defining/SmartThermostat/Présentations/Mi-parcours présentation BA2.pdf

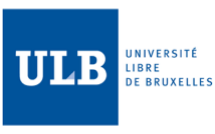
[picture p61: figure]

# « Thermostat intelligent »

## Groupe 11

Membres :
AMZUR Soufiane
DAUBRY Wilson
SERCU Stéphane
VERSTRAETEN Denis

Superviseur :
EPPE Stefan

1. Introduction
2. Conception
3. Thermostats auxiliaires
4. Thermostat central
5. Perspectives d’évolution
6. Conclusion

# Tables des matières

# Introduction

- Demande en objets intelligents croissante
- Création du thermostat connecté
- Utilisation simple et intuitive pour l’utilisateur

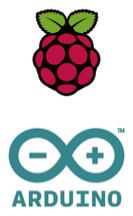
[picture p62: figure]

- Périphériques
- Central : Raspberry Pi Model 2b
- Auxiliaires : Arduino Nano V2

# Conception

- Diagramme complet
- Vue globale et structurée
- Partage efficace des différentes parties
- Développé dans la suite de la présentation

# Thermostats auxiliaires

Hardware

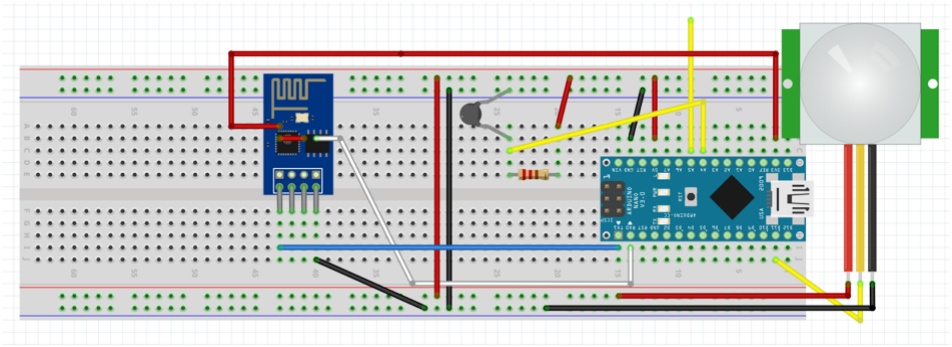
[picture p63: figure]

- Arduino Nano V2
- Thermistance
- PIR
- Module Wi-Fi
- Vanne thermostatique 4

# Thermostats auxiliaires

Software

- PIR : HIGH ou LOW
- Vanne thermostatique : valeur analogique convertie en %
- Thermistance : valeur analogique convertie en tension, obtention de la température grâce à la loi de Steinhart-Hart

Lecture des capteurs :

# Thermostats auxiliaires

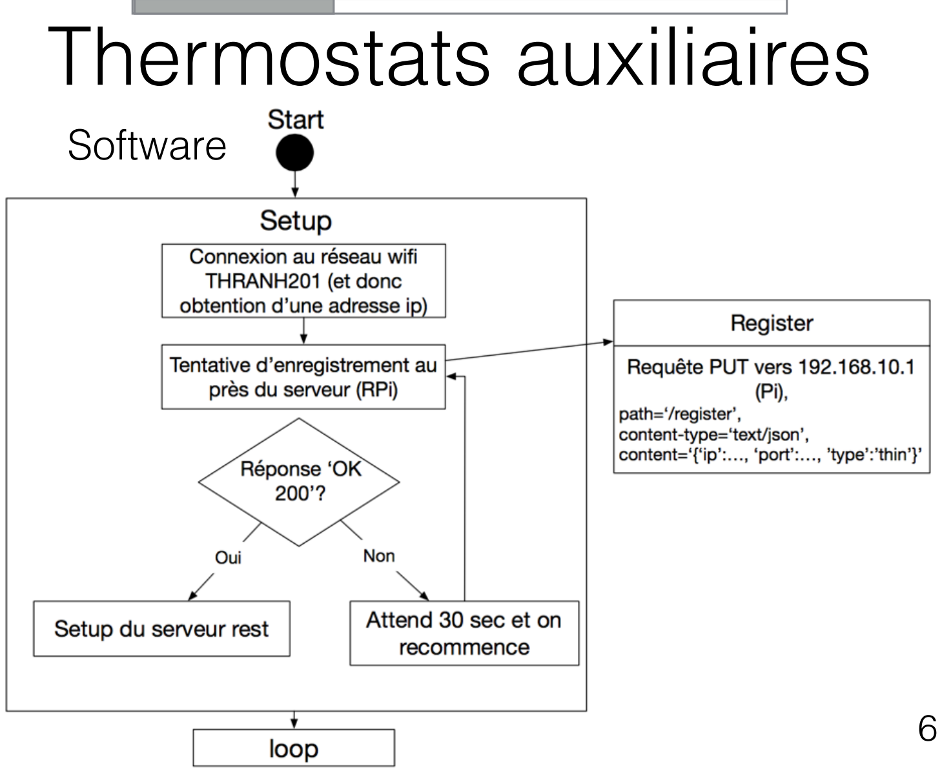
[picture p64: page 7]

Software

# Thermostats auxiliaires

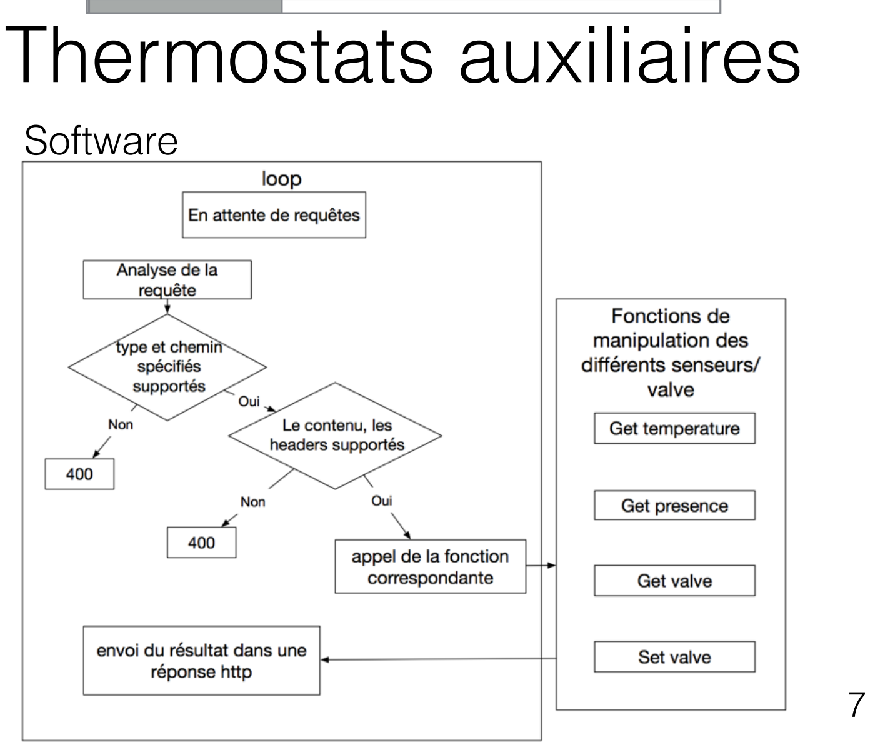
[picture p65: page 8]

Software

# Thermostat central

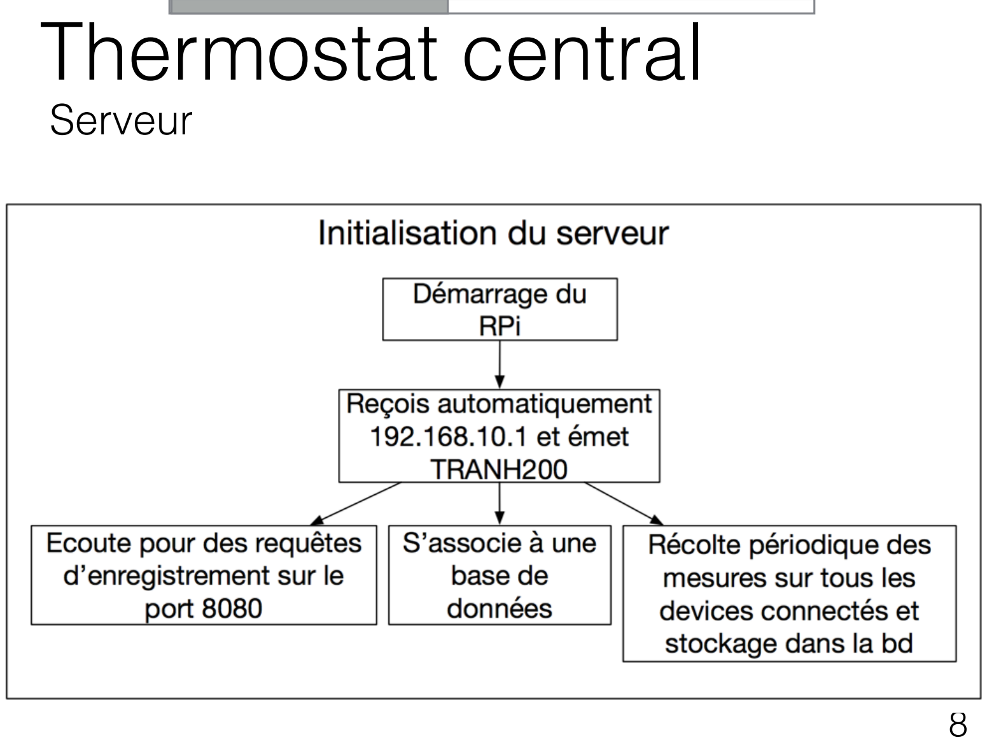
[picture p66: page 9]

Serveur

# Thermostat central

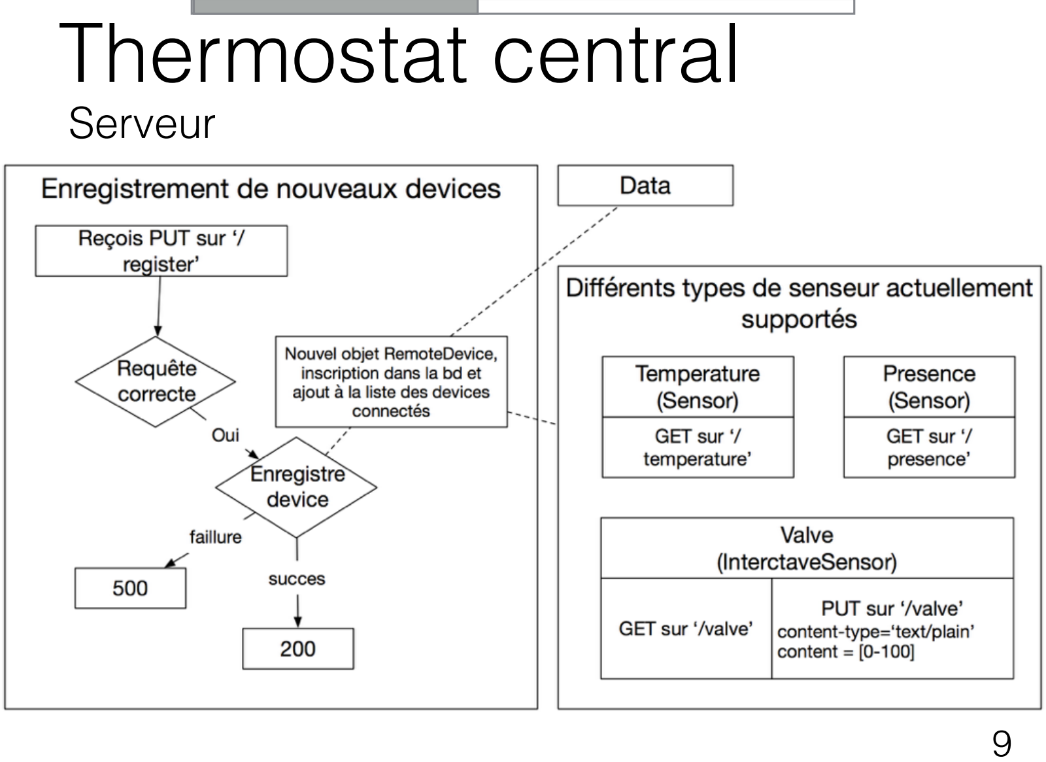
[picture p67: page 10]

Serveur

# Thermostat central

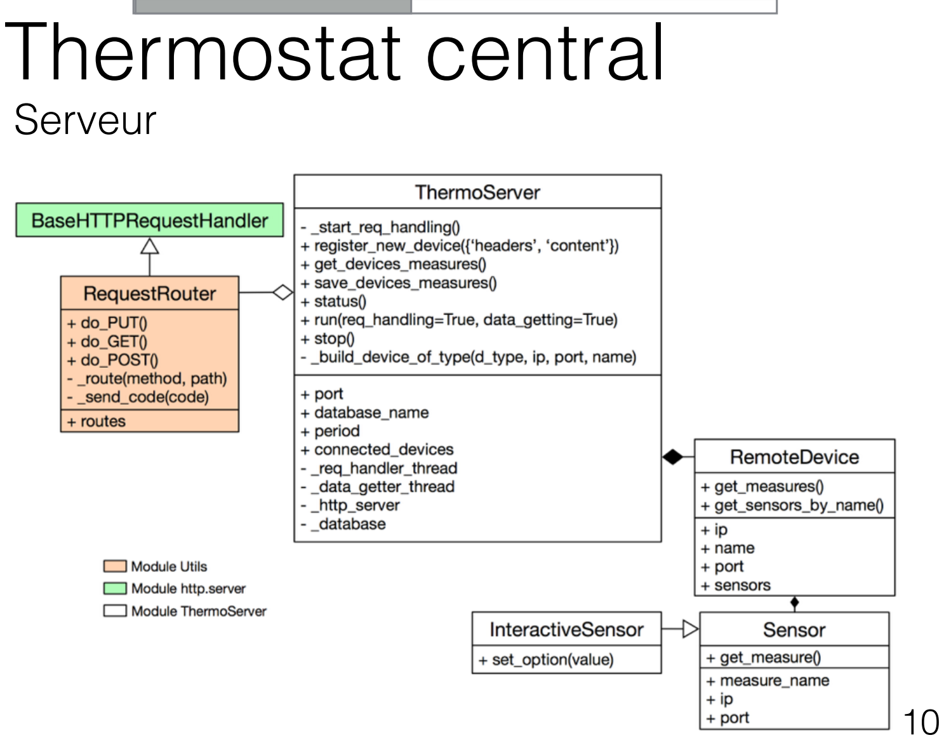
[picture p68: page 11]

Serveur

# Thermostat central

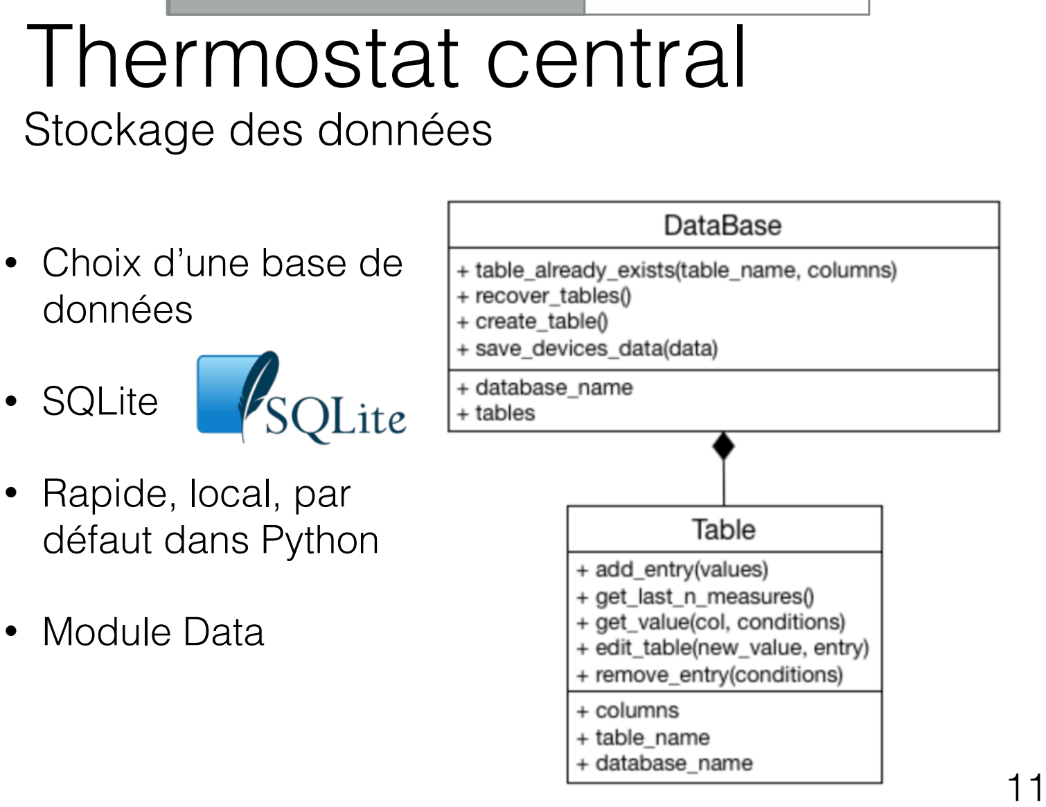
[picture p69: page 12]

- Choix d’une base de
données
- SQLite
- Rapide, local, par
défaut dans Python
- Module Data

Stockage des données

# Thermostat central

Stockage des données

- Une nouvelle table par connexion
- Pas correct

Implémentation actuelle

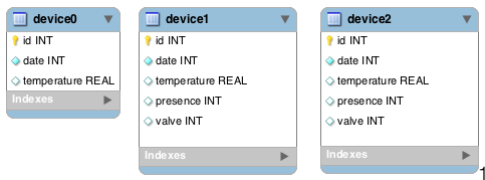
[picture p70: figure]

# Thermostat central

Stockage des données

- Une table principale
- Une table de Remote Devices

Implémentation à venir

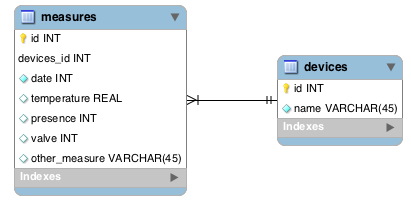
[picture p71: figure]

# Perspectives d’evolution

- Validation entière du système
- Analyse critique du sytème
- Modélisation dynamique du chauffage
- Modélisation de l’algorithme anticipatif
- Implémentation algorithme « smart »
- Tests et validation

# Conclusion

- Câblage Remote Devices
- Implémentation Arduino
- Implémentation serveur
- Implémentation base de données
- Communication entre Remote Devices et serveur

Bibliographie : cf.rapport intermédiaire

Merci pour votre attention.

# Relation de Steinhart-Hart

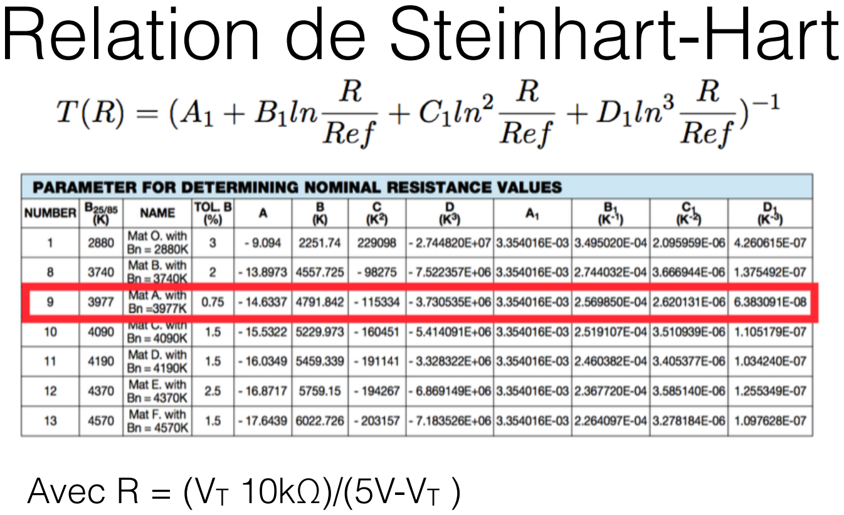
[picture p72: page 18]

Avec R = (VT 10kΩ)/(5V-VT )
