defining/SmartThermostat/Présentations/Présentation finale.pdf

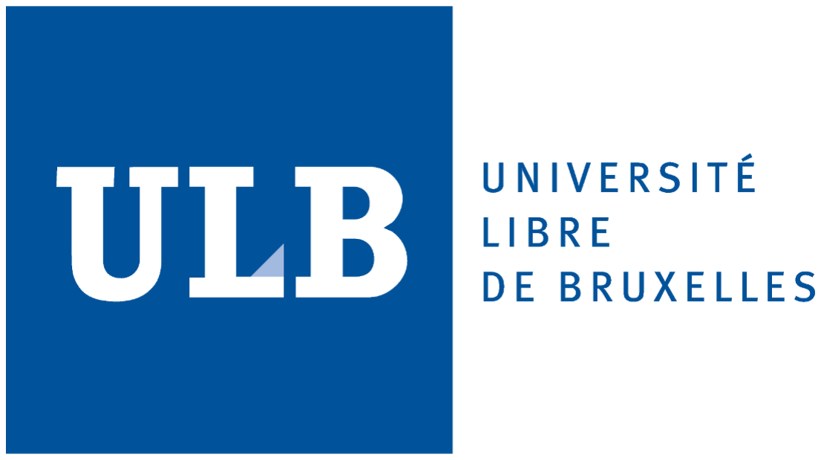
[picture p73: figure]

# « Thermostat intelligent »

## Groupe 11

Membres :
AMZUR Soufiane
DAUBRY Wilson
SERCU Stéphane
VERSTRAETEN Denis

Superviseur :
EPPE Stefan

Lecteur :
VERMEIR Aurélien

1. Introduction
2. Conception
3. Thermostats auxiliaires
4. Thermostat central
5. Intelligence
6. Validation
7. Conclusion

# Table des matières

# Introduction

- Demande en objets intelligents croissante
- Création du thermostat connecté
- Utilisation simple et intuitive pour l’utilisateur

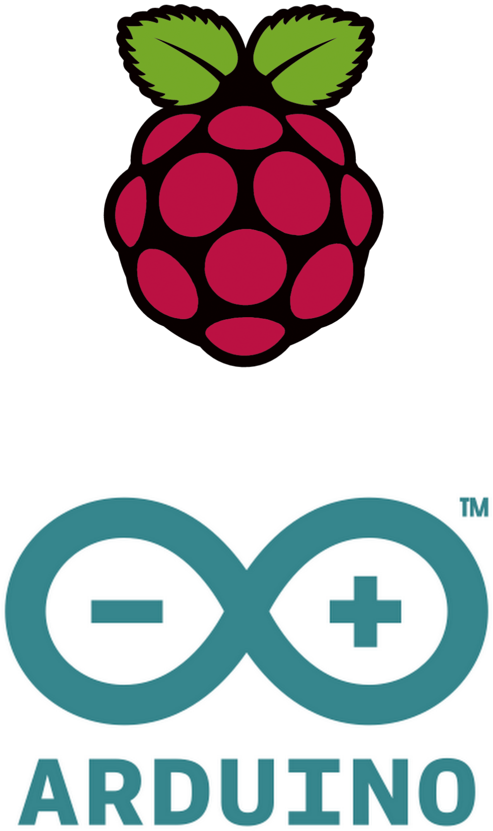
[picture p74: figure]

- Périphériques
- Central : Raspberry Pi Model 2b
- Auxiliaires : Arduino Nano V2

# Conception

- Diagramme complet
- Vue globale et structurée
- Partage efficace des différentes parties
- Développé dans la suite de la présentation

# Thermostats auxiliaires

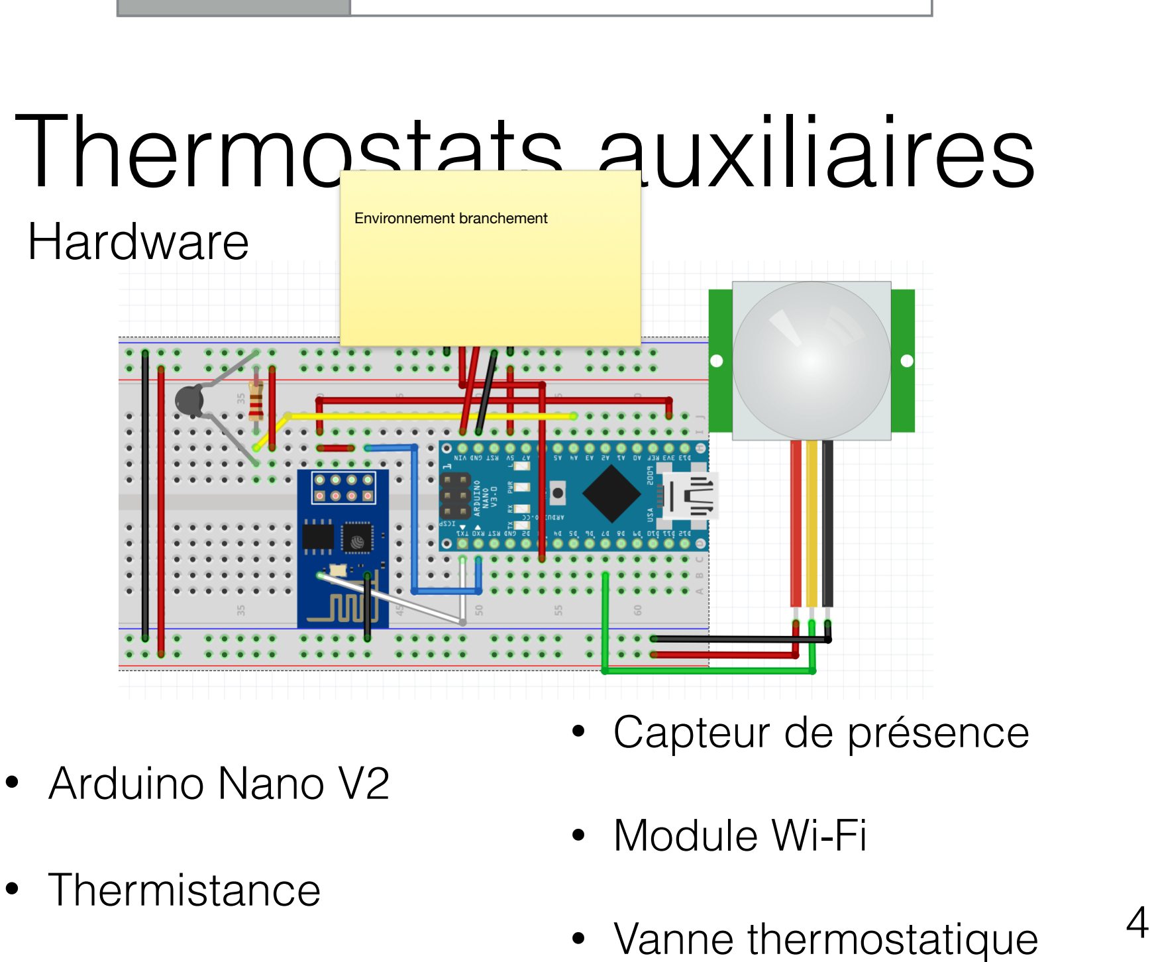
[picture p75: page 5]

Hardware

- Arduino Nano V2
- Thermistance
- Capteur de présence
- Module Wi-Fi
- Vanne thermostatique 4

Environnement branchement

# Thermostats auxiliaires

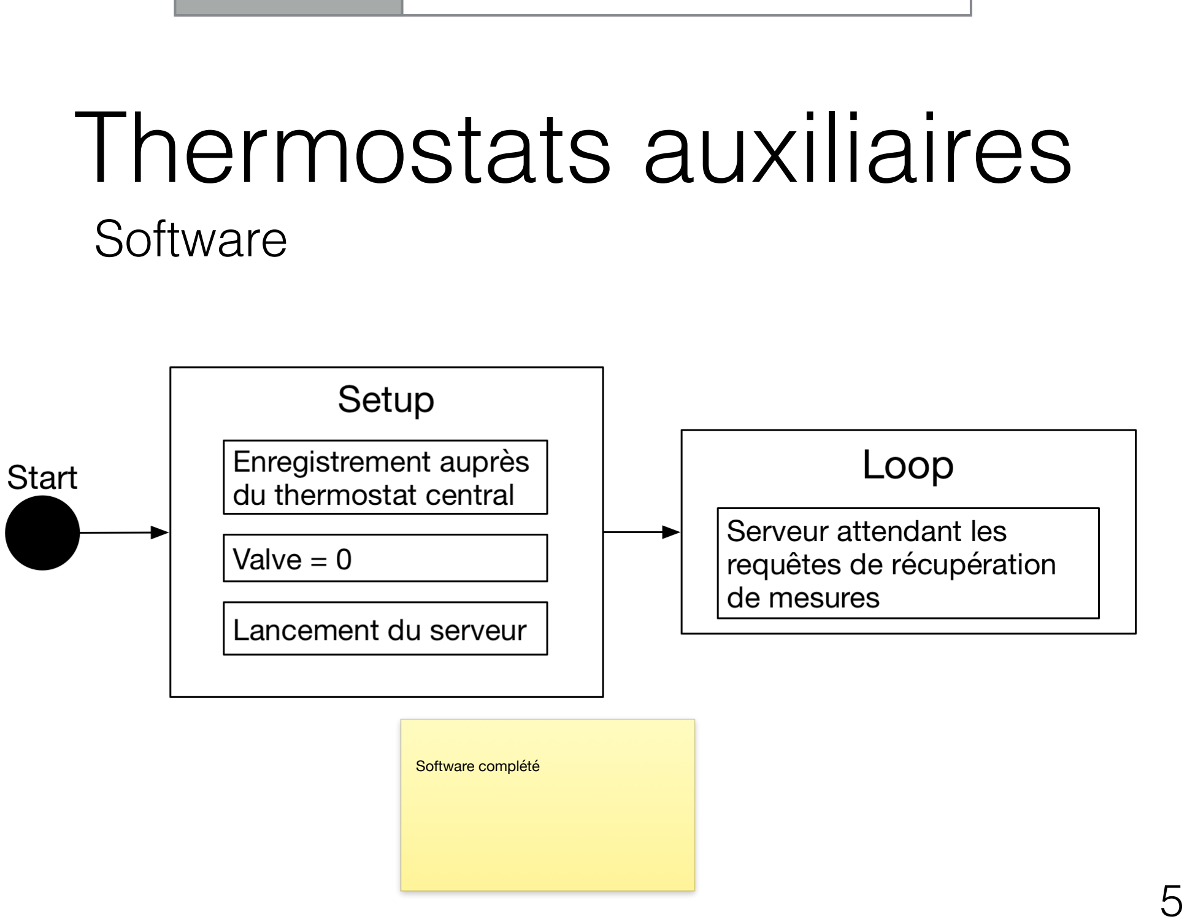
[picture p76: page 6]

Software

Software complété

# Thermostat central

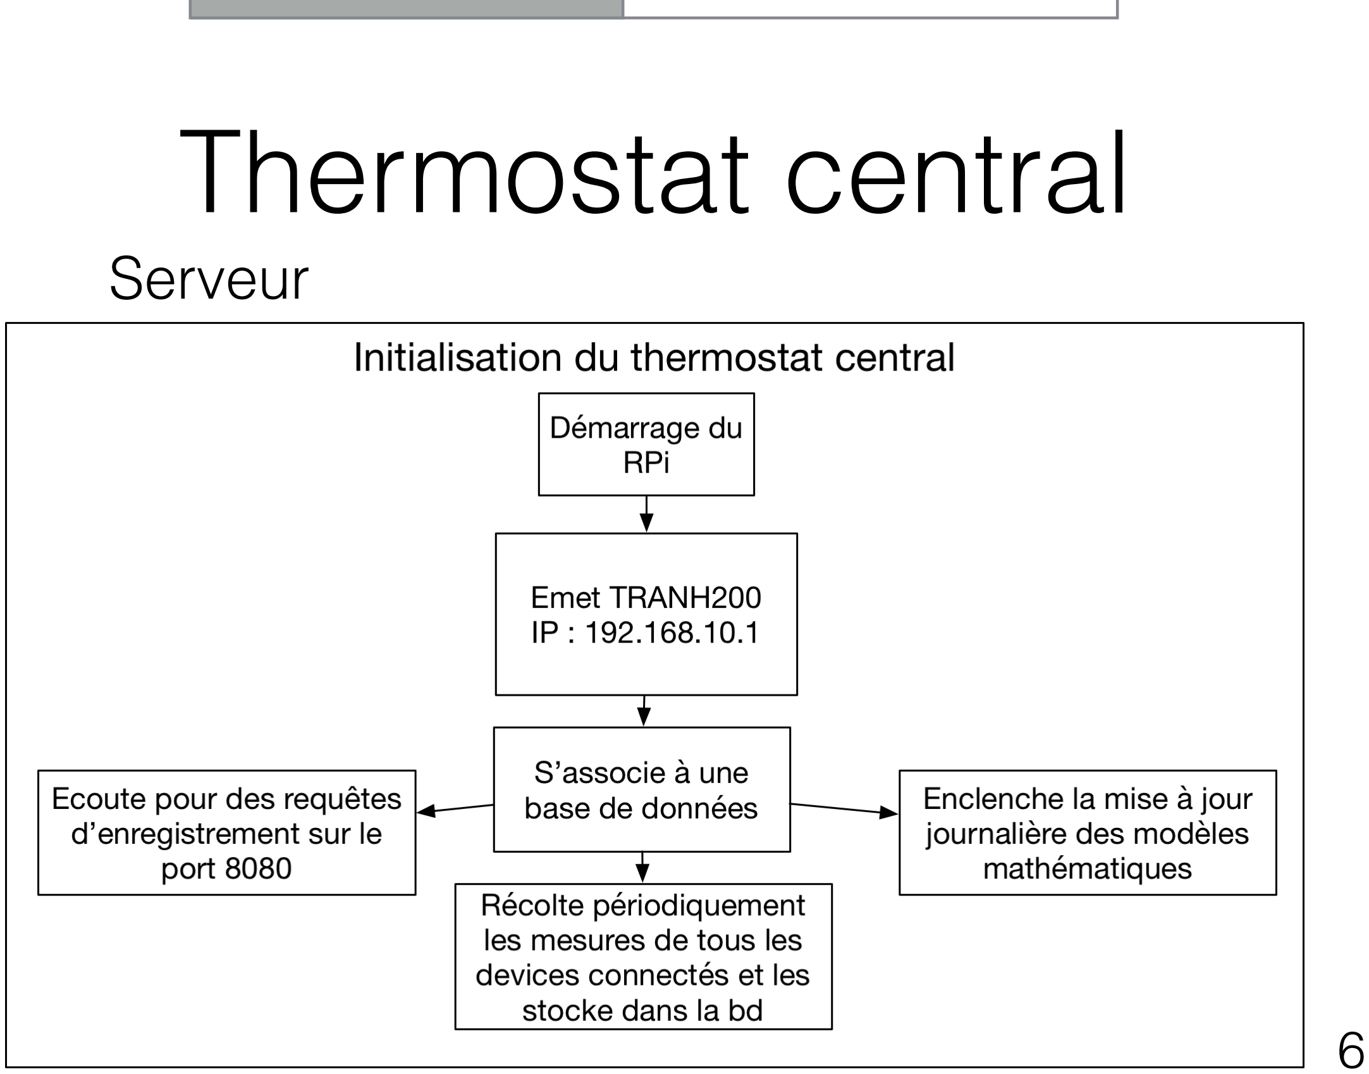
[picture p77: page 7]

Serveur

# Thermostat central

Serveur

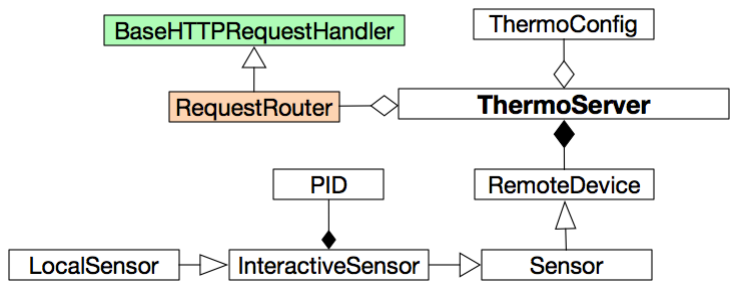
[picture p78: figure]

# Thermostat central

- Choix d’une base de
données

•

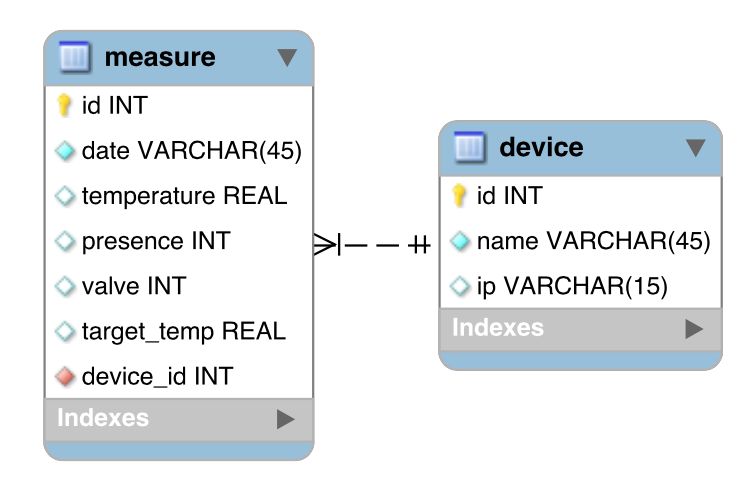
[picture p79: figure]
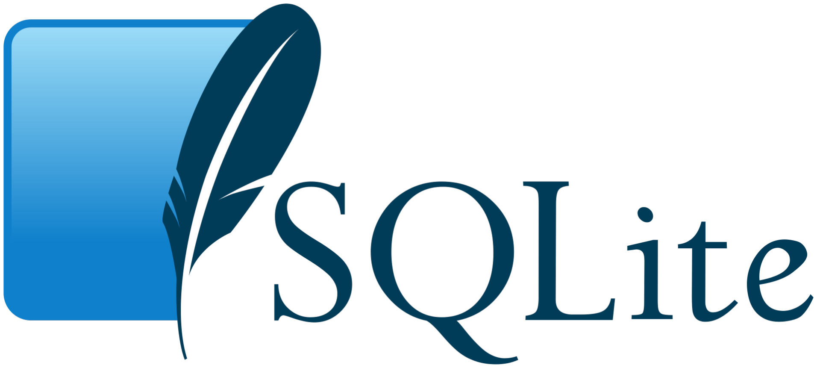
[picture p80: figure]

- Local, par défaut dans
Python
- Module Data

Stockage des données

# Thermostat central

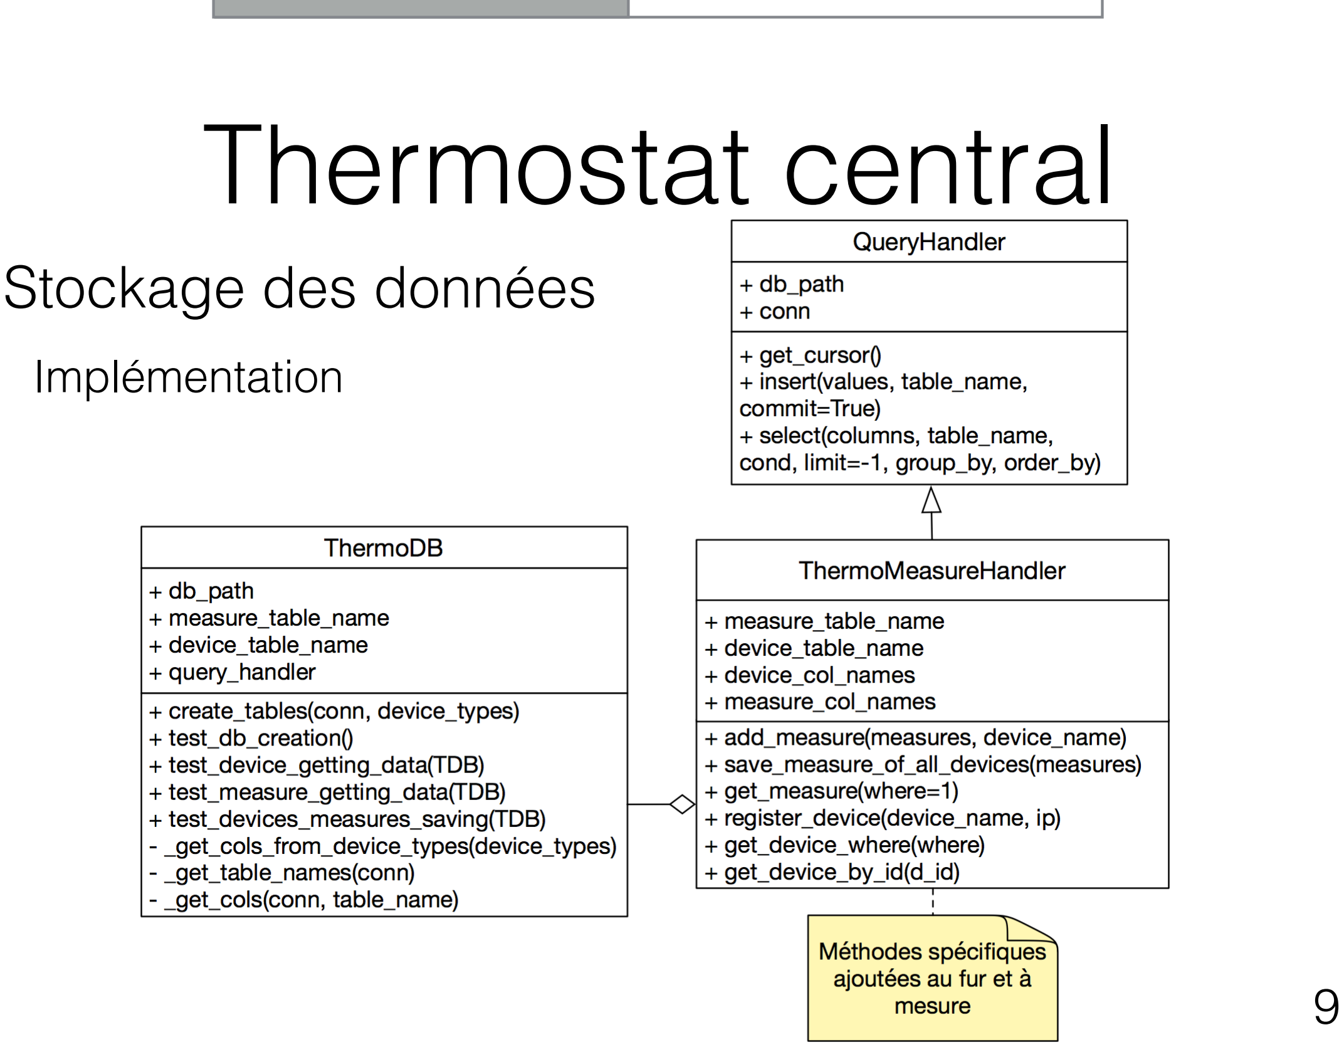
[picture p81: page 10]

Stockage des données

Implémentation

# Thermostat central

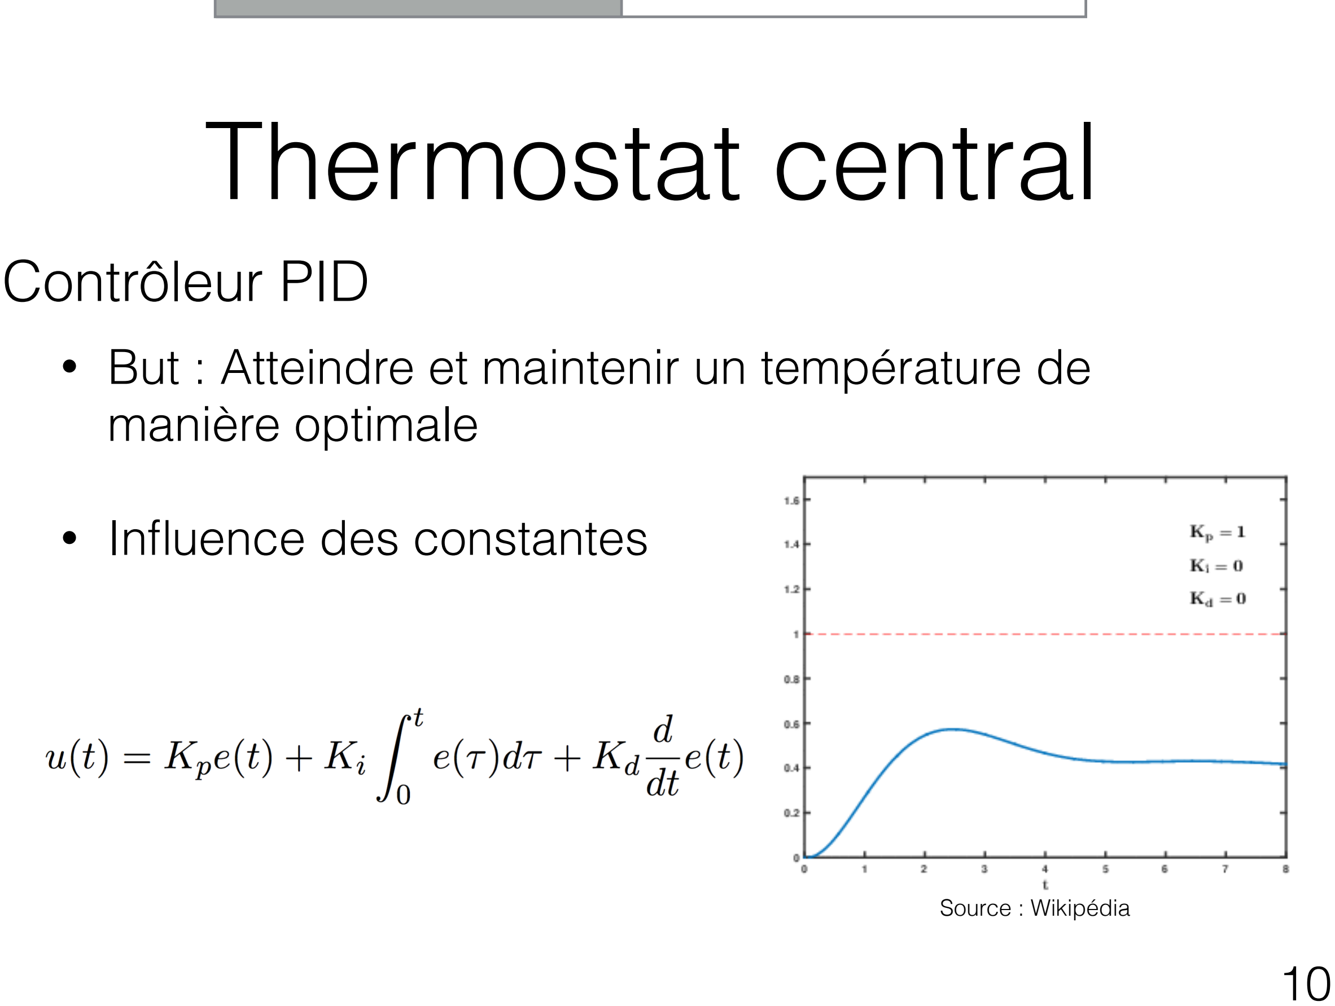
[picture p82: page 11]

Contrôleur PID

- But : Atteindre et maintenir un température de manière optimale
- Influence des constantes

Source : Wikipédia

# Intelligence

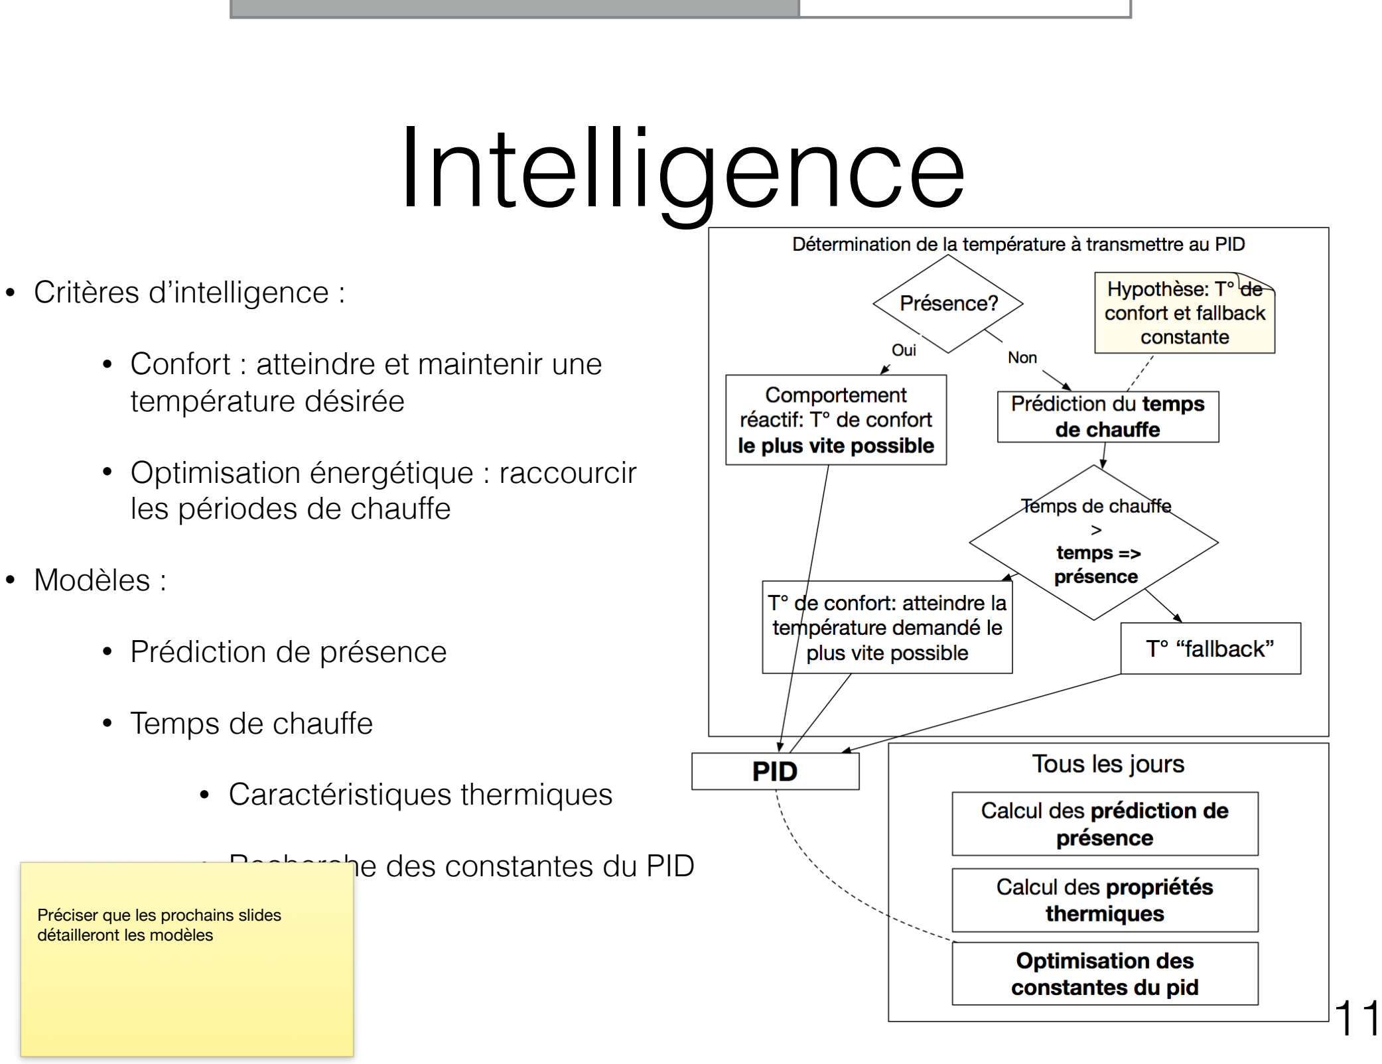
[picture p83: page 12]

- Critères d’intelligence :
- Confort : atteindre et maintenir une température désirée
- Optimisation énergétique : raccourcir les périodes de chauffe
- Modèles :
- Prédiction de présence
- Temps de chauffe
- Caractéristiques thermiques
- Recherche des constantes du PID

Préciser que les prochains slides détailleront les modèles

# Intelligence

Prédiction de présence

- Fonction de probabilité
- Interpolation polynomiale

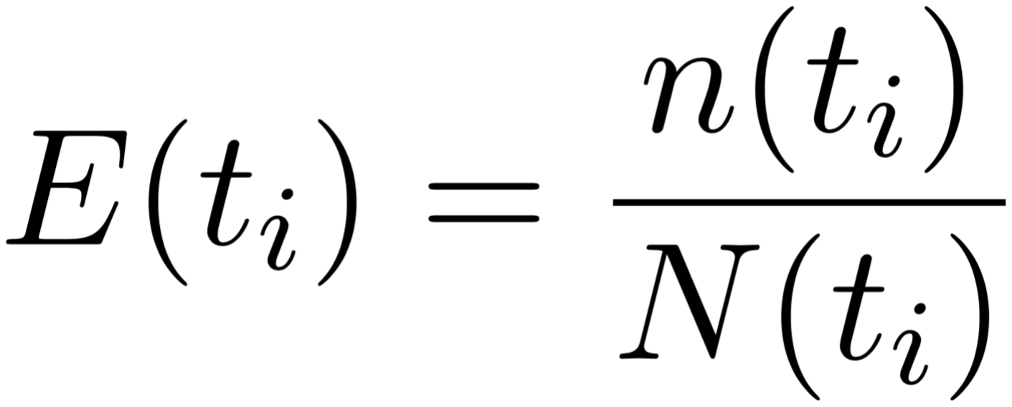
[picture p84: figure]
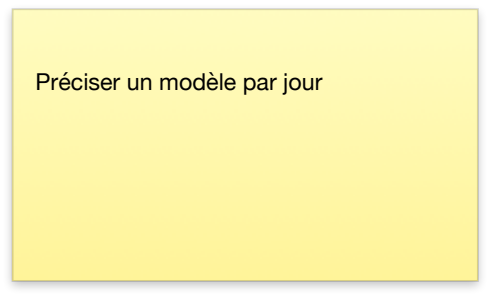
[picture p85: figure]
Préciser un modèle par jour
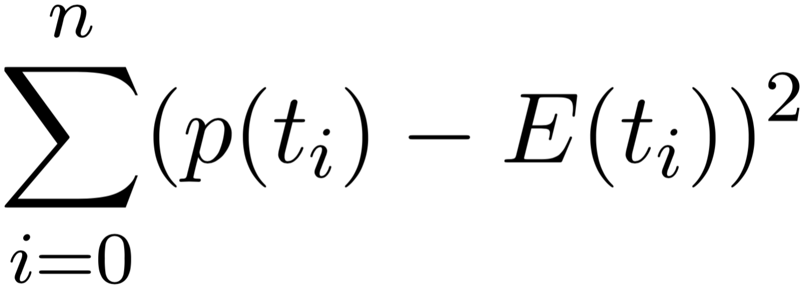
[picture p86: figure]

# Intelligence

Caractéristiques thermiques

- Evolution de la température
- Bilan énergétique

- Minimisation de la différence entre la température actuelle et la température désirée

# Intelligence

Recherche des constantes du PID

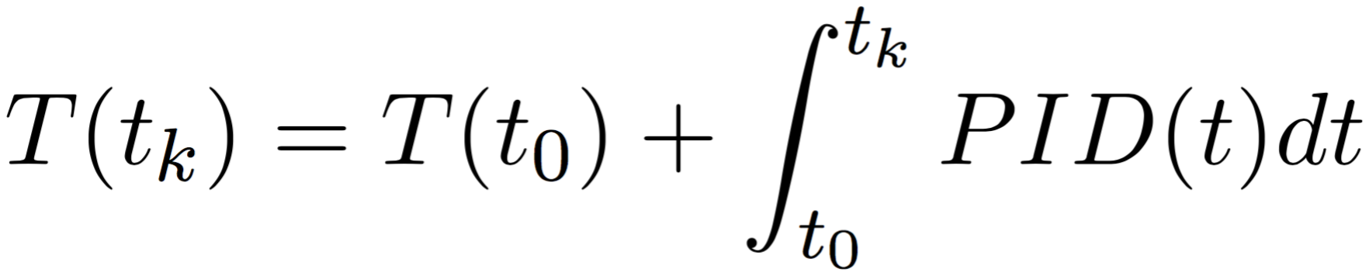
[picture p87: figure]
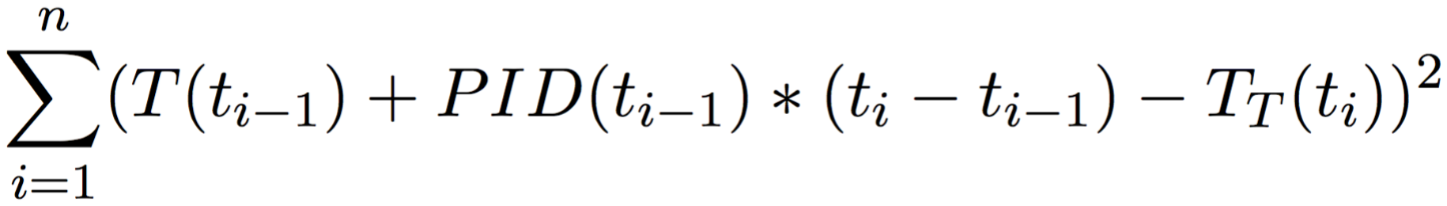
[picture p88: figure]

# Validation

Tests d’implémentation

- Tests du « thin thermostat »
- Tests unitaires des modules du serveur
- Tests généraux du serveur

# Validation

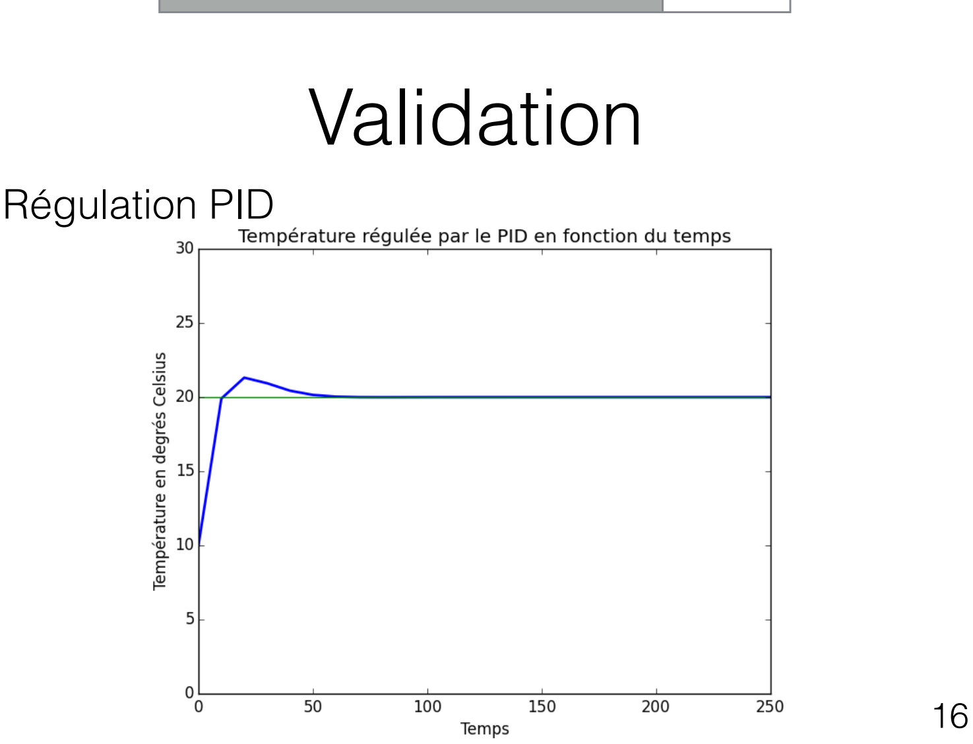
[picture p89: page 17]

Régulation PID

# Validation

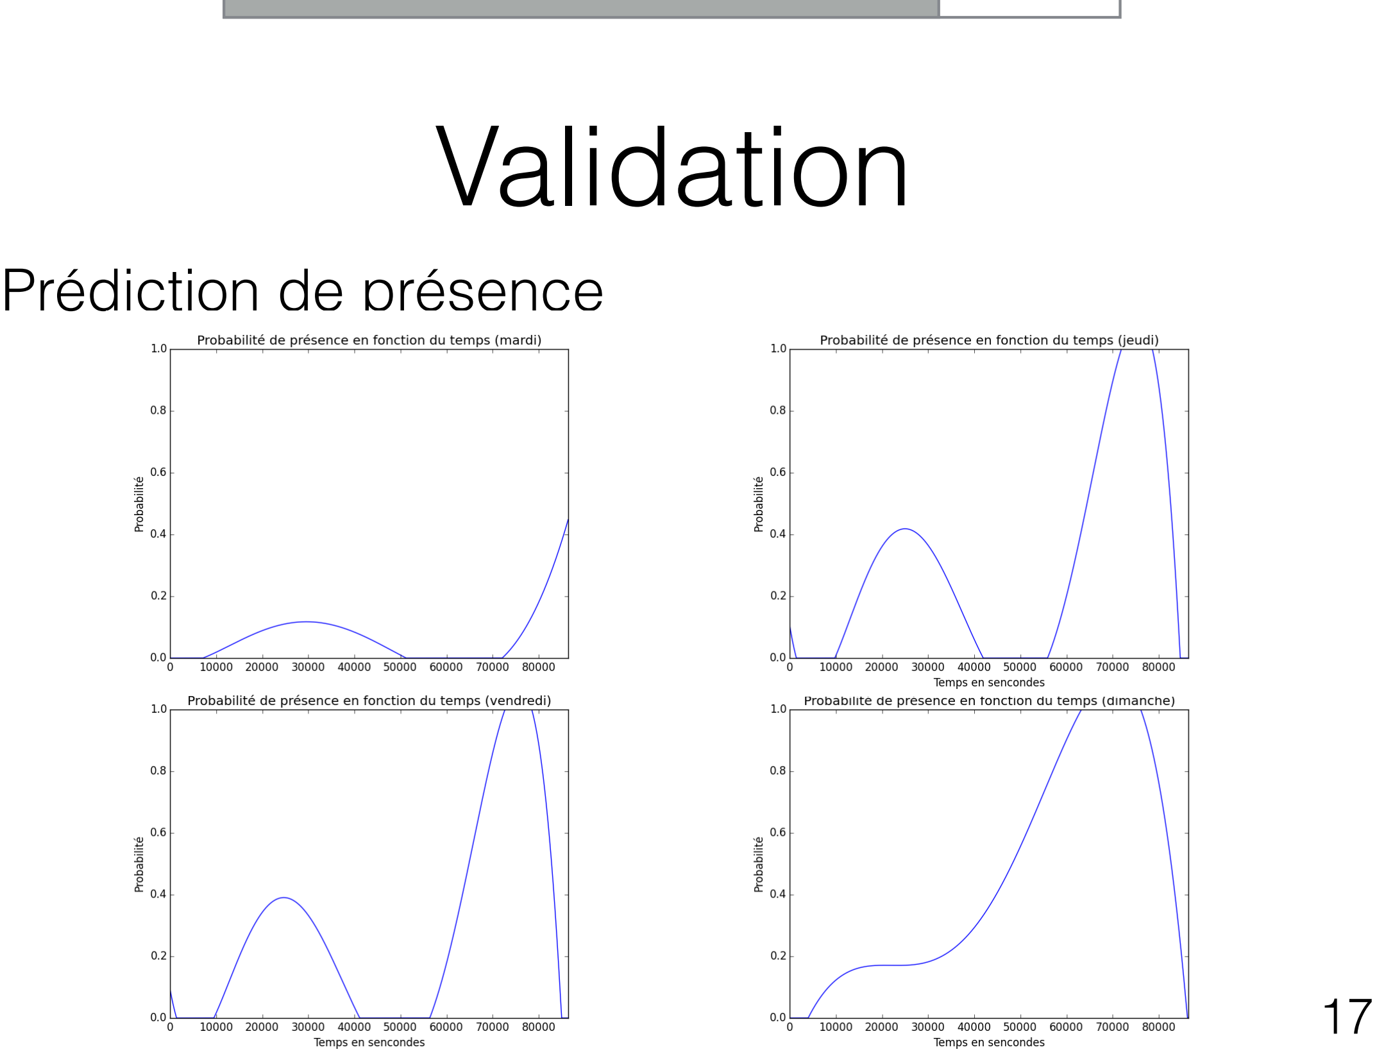
[picture p90: page 18]

Prédiction de présence

# Conclusion

- Perspectives d’évolution
- Corriger certains et affiner les modèles théoriques
- Identification des Remote Devices
- Ajouter d’autres types de senseurs
- Affiner la notion de confort
- Interface graphique, accès aux informations
- Optimiser
- Réflexion
- Pas de perte de temps sur le débogage

Bibliographie : cf.rapport intermédiaire

Merci pour votre attention

# Annexe

A1

- Fonctionnement de groupe
- Une réunion par semaine
- OverLeaf
- Dropbox
- Skype
- Facebook

# Annexe

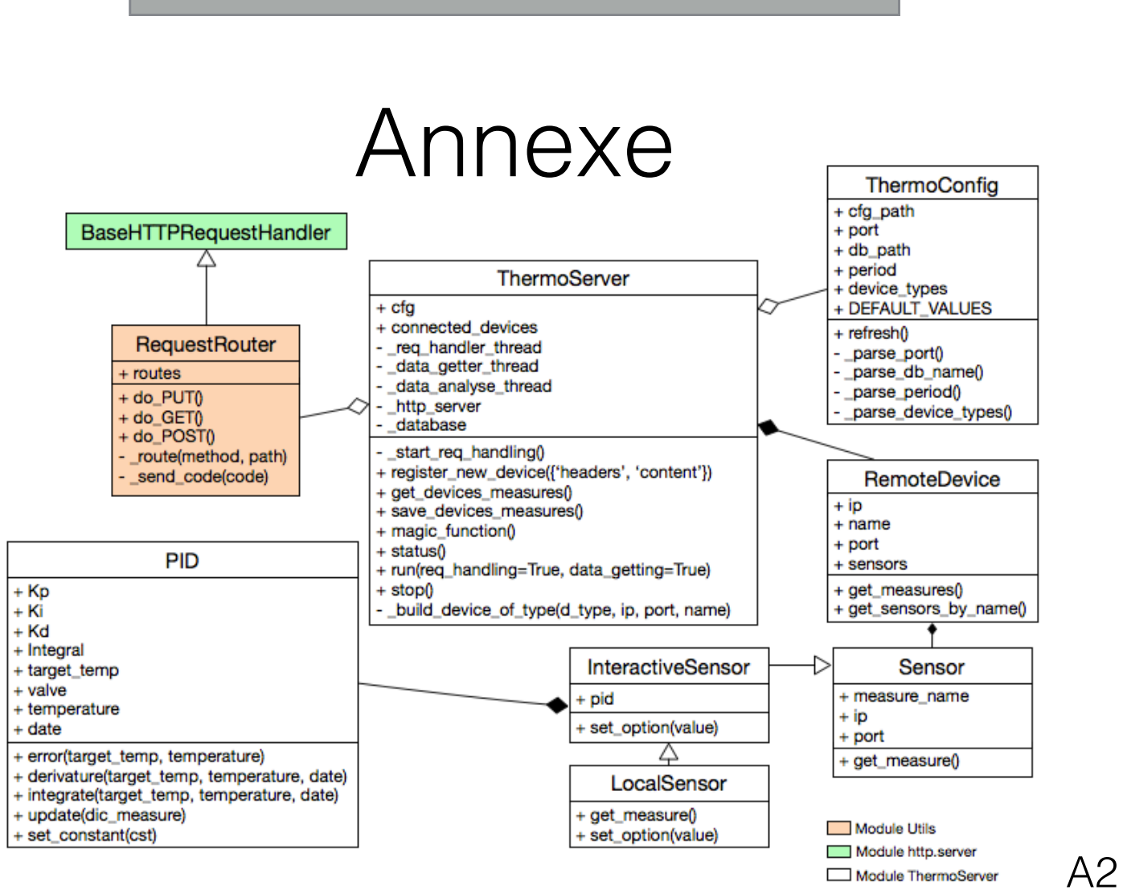
[picture p91: page 22]

A2
