defining/SmartThermostat/Rapports/Rapport final/thermostat-connecte/pdf/diagrams_complet.pdf

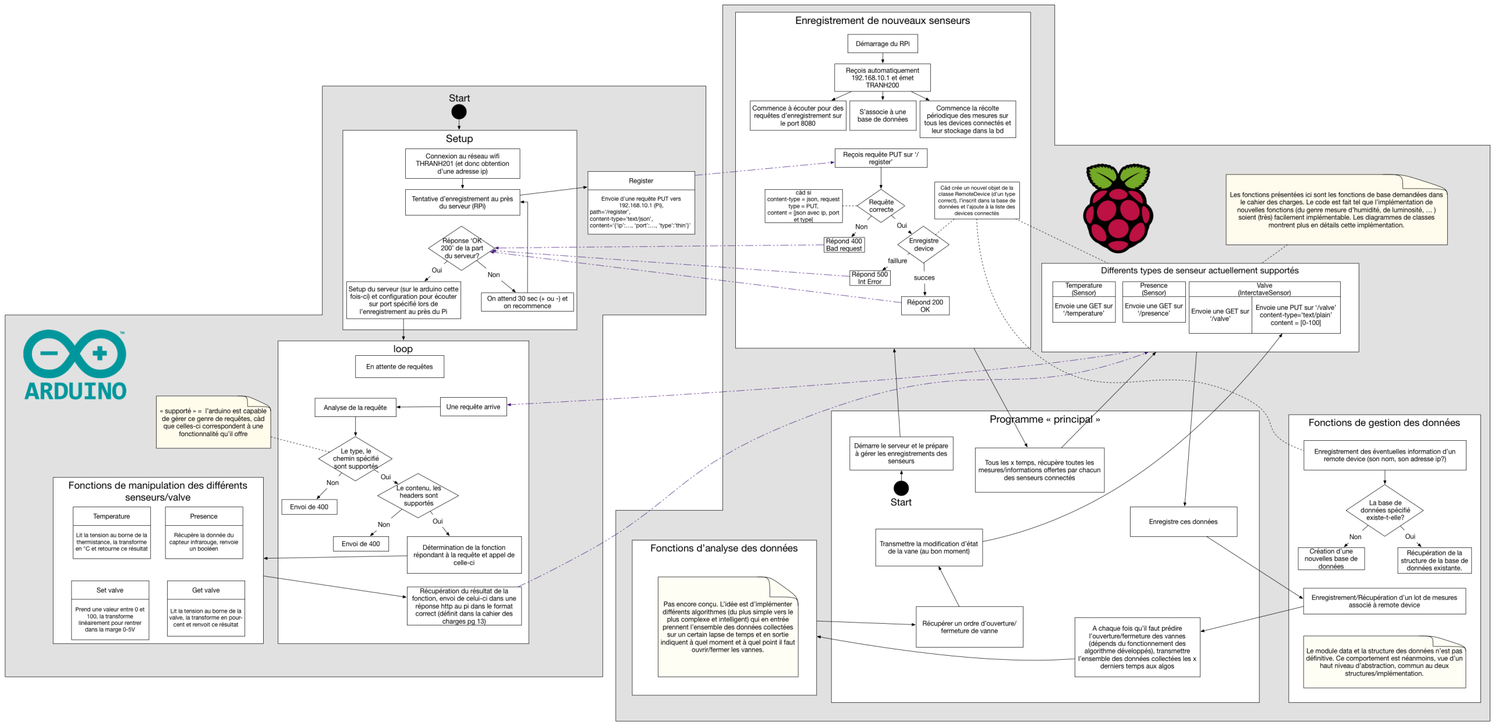
[picture p92: page 1]
