defining/SmartThermostat/Diagrammes/Diagrammes PNG/behav_intelligence.png

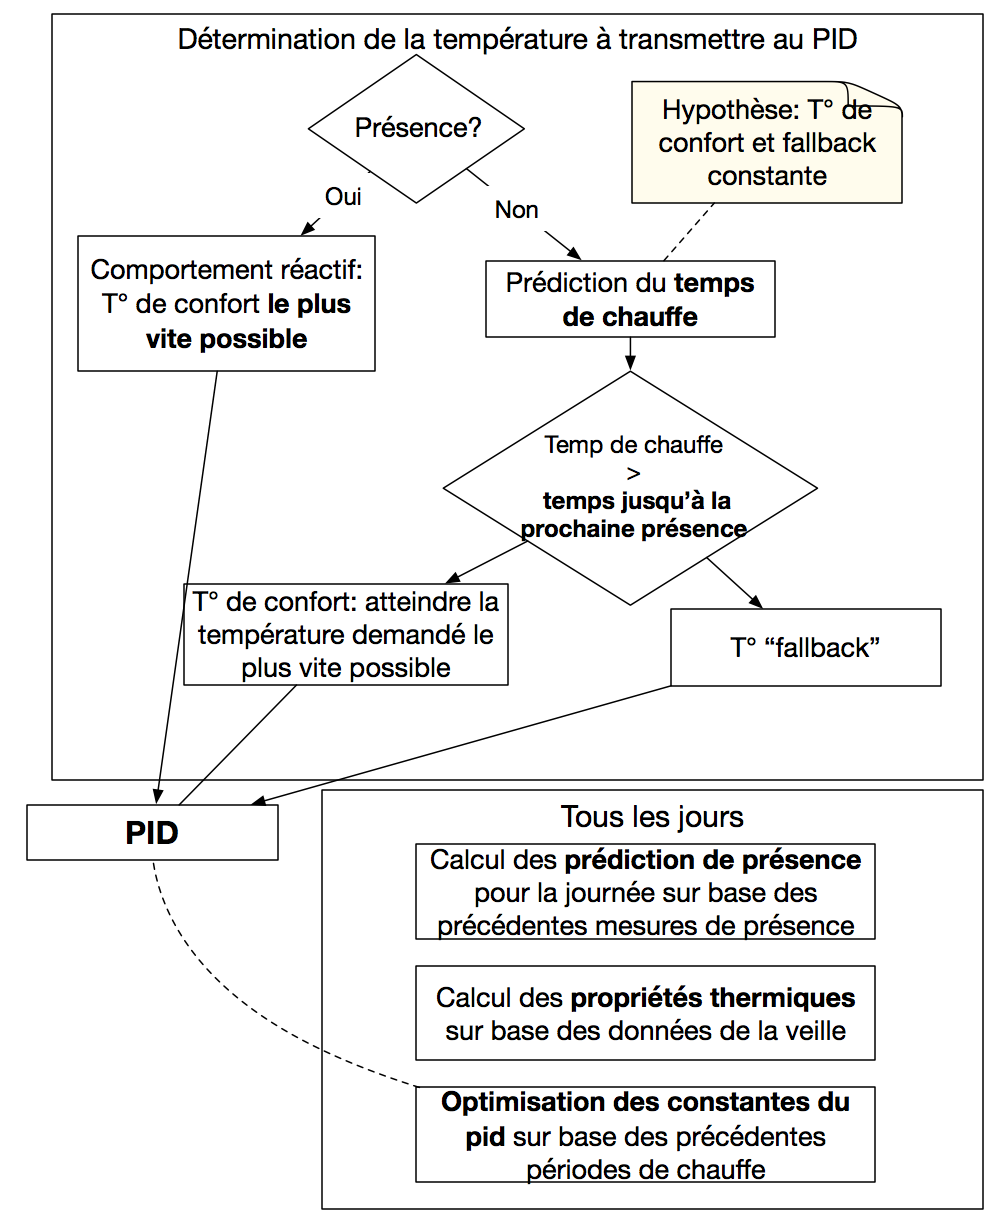
Diagrammes/Diagrammes PNG/behav_intelligence.png
