defining/SmartThermostat/Diagrammes/Diagrammes PNG/behav_server.png

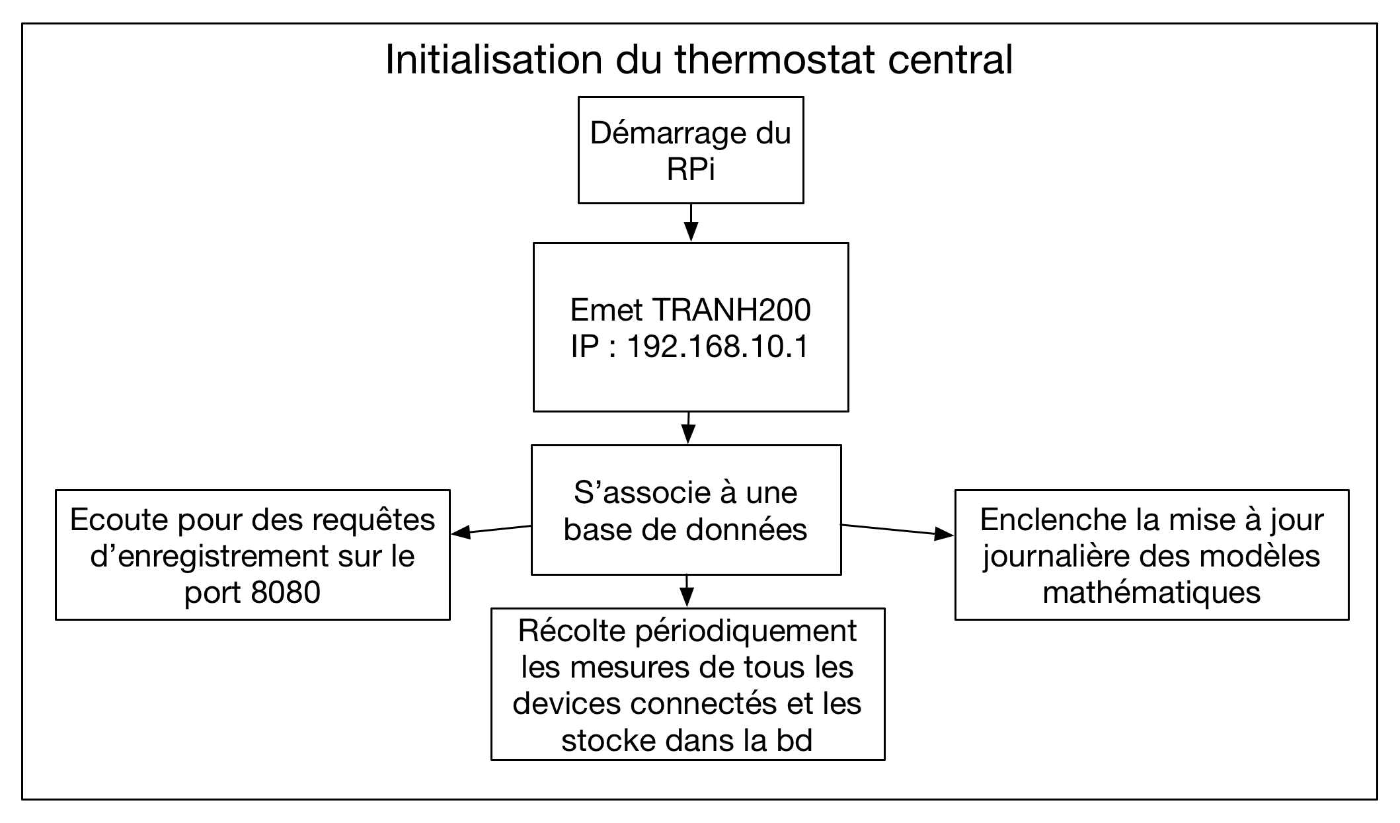
Diagrammes/Diagrammes PNG/behav_server.png
