defining/SmartThermostat/Diagrammes/Diagrammes PNG/behav_thin.png

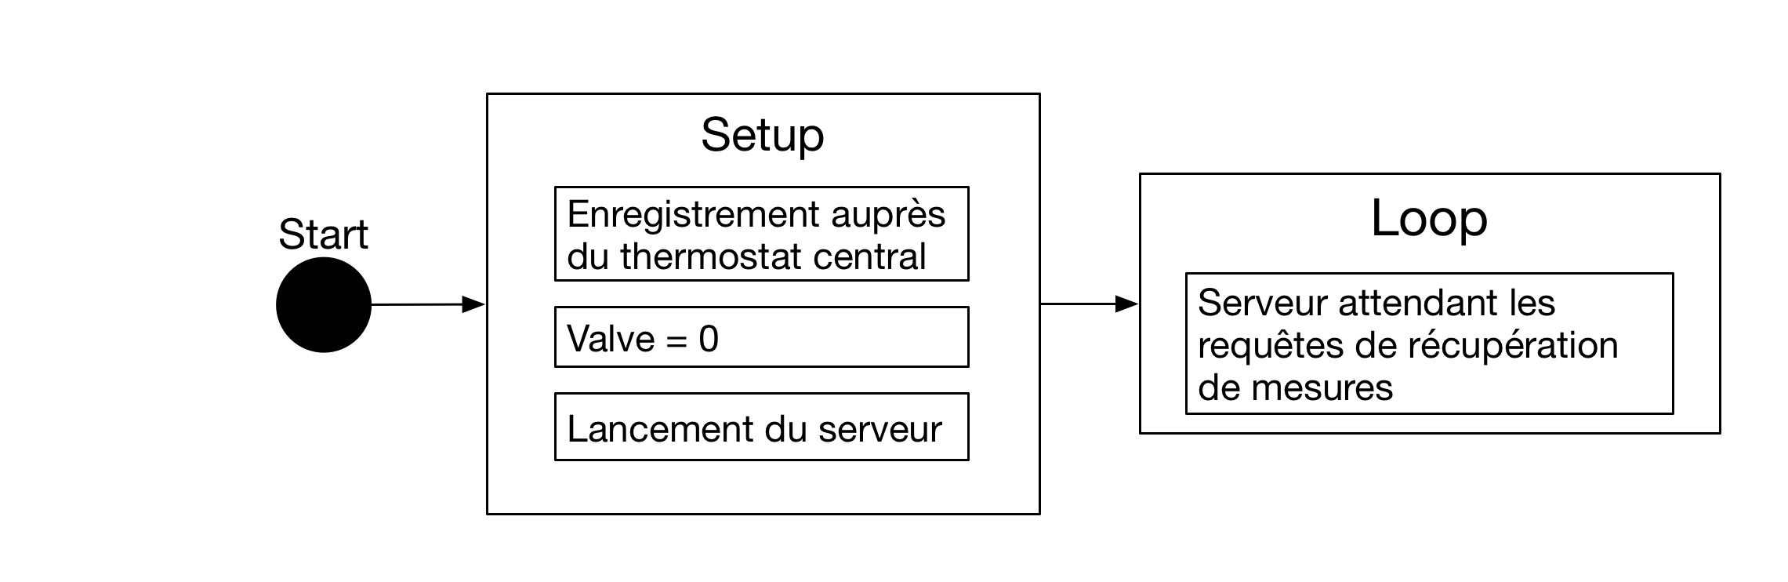
Diagrammes/Diagrammes PNG/behav_thin.png
