defining/SmartThermostat/Diagrammes/Diagrammes PNG/class_annexe_thermoserver.png

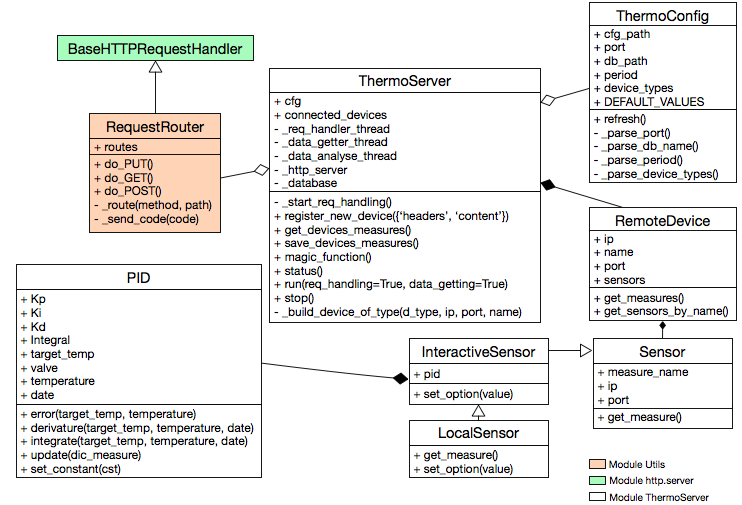
Diagrammes/Diagrammes PNG/class_annexe_thermoserver.png
