defining/SmartThermostat/Diagrammes/Diagrammes PNG/diagrams_complet.png

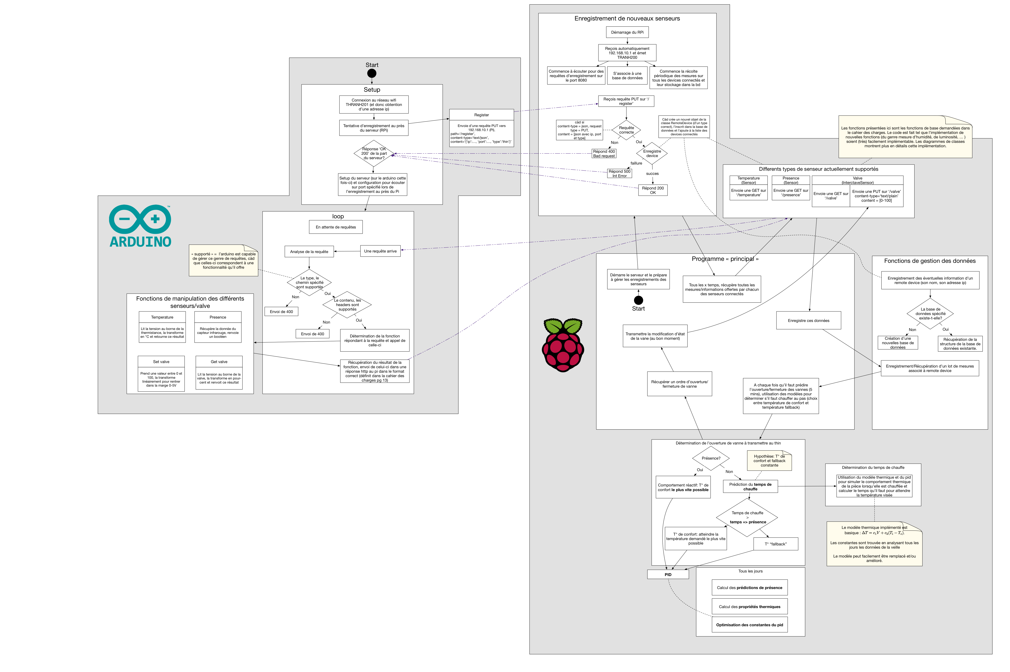
Diagrammes/Diagrammes PNG/diagrams_complet.png
