defining/SmartThermostat/Diagrammes/Diagrammes sur omnigraffle/diagrams_complet.graffle/image1.tiff

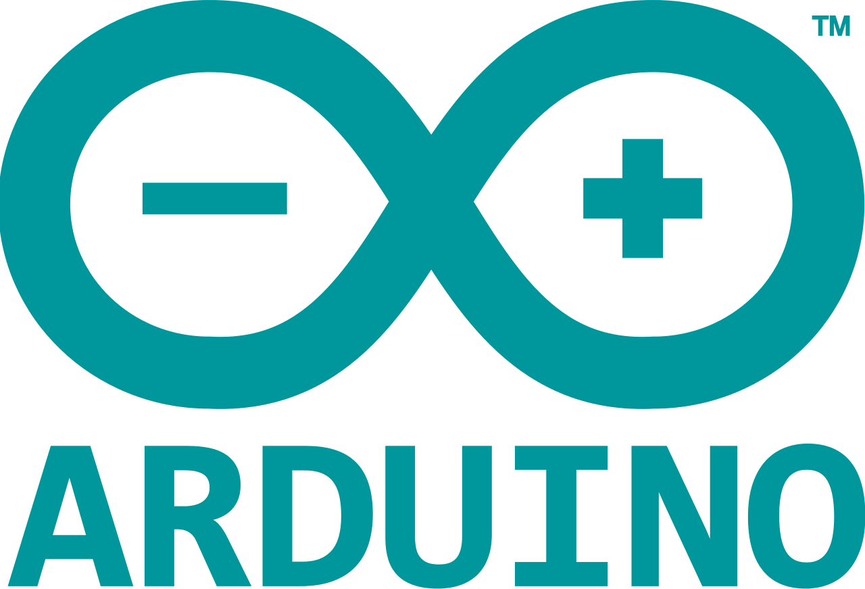
Diagrammes/Diagrammes sur omnigraffle/diagrams_complet.graffle/image1.tiff
