defining/SmartThermostat/Diagrammes/Diagrammes sur omnigraffle/diagrams_complet.graffle/image2.tiff

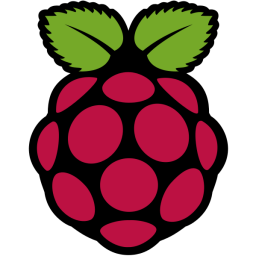
Diagrammes/Diagrammes sur omnigraffle/diagrams_complet.graffle/image2.tiff
