defining/SmartThermostat/Rapports/Rapport des autres groupes/projet-thermostat/Capture.PNG

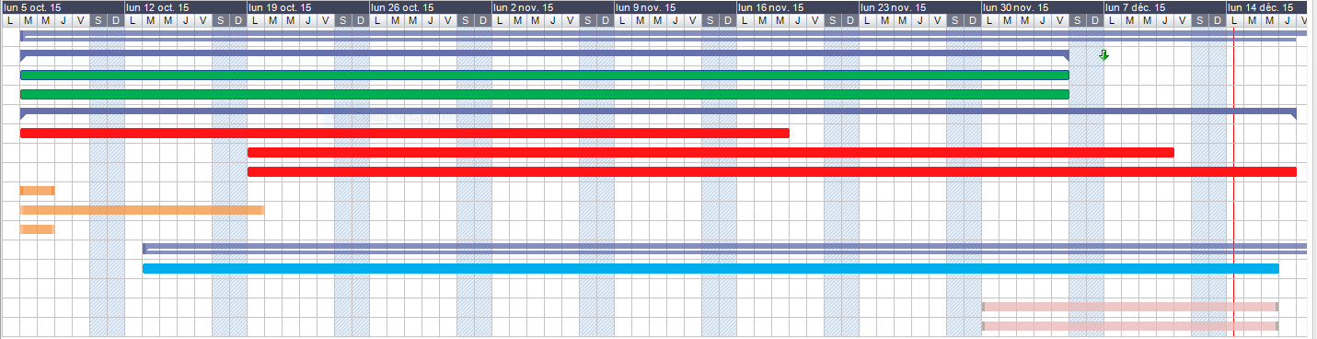
Rapports/Rapport des autres groupes/projet-thermostat/Capture.PNG
