defining/SmartThermostat/Rapports/Rapport des autres groupes/projet-thermostat/code_detecteur_presence.png

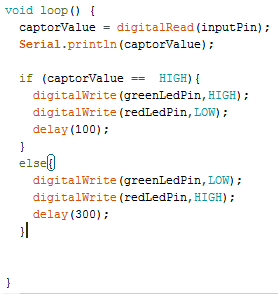
Rapports/Rapport des autres groupes/projet-thermostat/code_detecteur_presence.png
