defining/SmartThermostat/Rapports/Rapport des autres groupes/projet-thermostat/code_thermistance.png

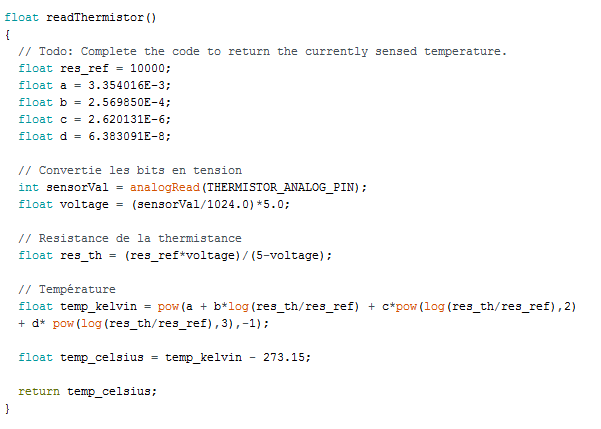
Rapports/Rapport des autres groupes/projet-thermostat/code_thermistance.png
