defining/SmartThermostat/Rapports/Rapport des autres groupes/projet-thermostat/environnement_simulation.png

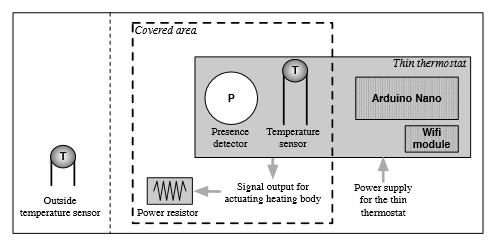
Rapports/Rapport des autres groupes/projet-thermostat/environnement_simulation.png
