defining/SmartThermostat/Rapports/Rapport des autres groupes/projet-thermostat/graphe1.jpg

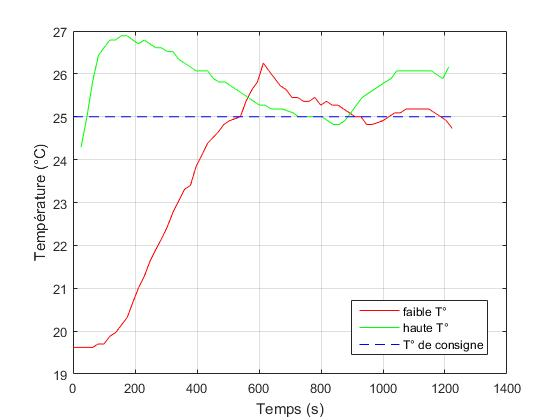
Rapports/Rapport des autres groupes/projet-thermostat/graphe1.jpg
