defining/SmartThermostat/Rapports/Rapport des autres groupes/projet-thermostat/graphe2.jpg

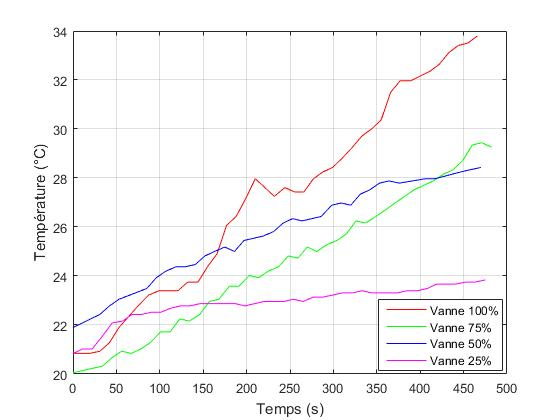
Rapports/Rapport des autres groupes/projet-thermostat/graphe2.jpg
