defining/SmartThermostat/Rapports/Rapport des autres groupes/projet-thermostat/onoff.jpg

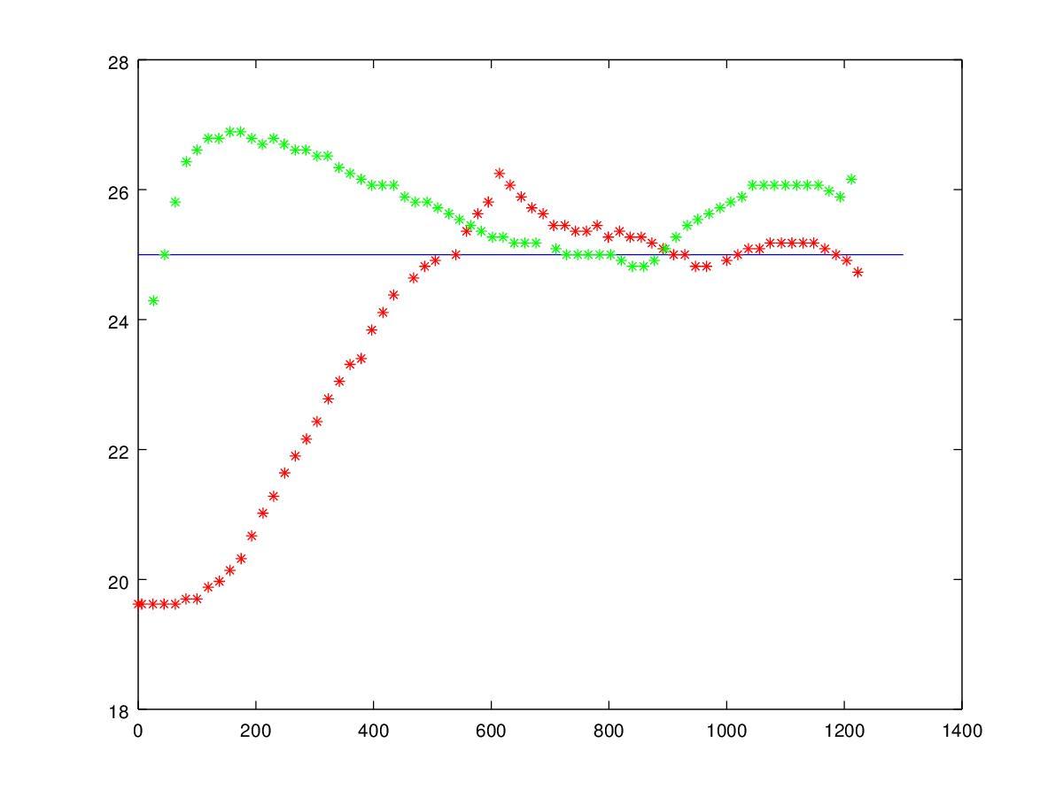
Rapports/Rapport des autres groupes/projet-thermostat/onoff.jpg
