defining/SmartThermostat/Rapports/Rapport des autres groupes/projet-thermostat/pid14.jpg

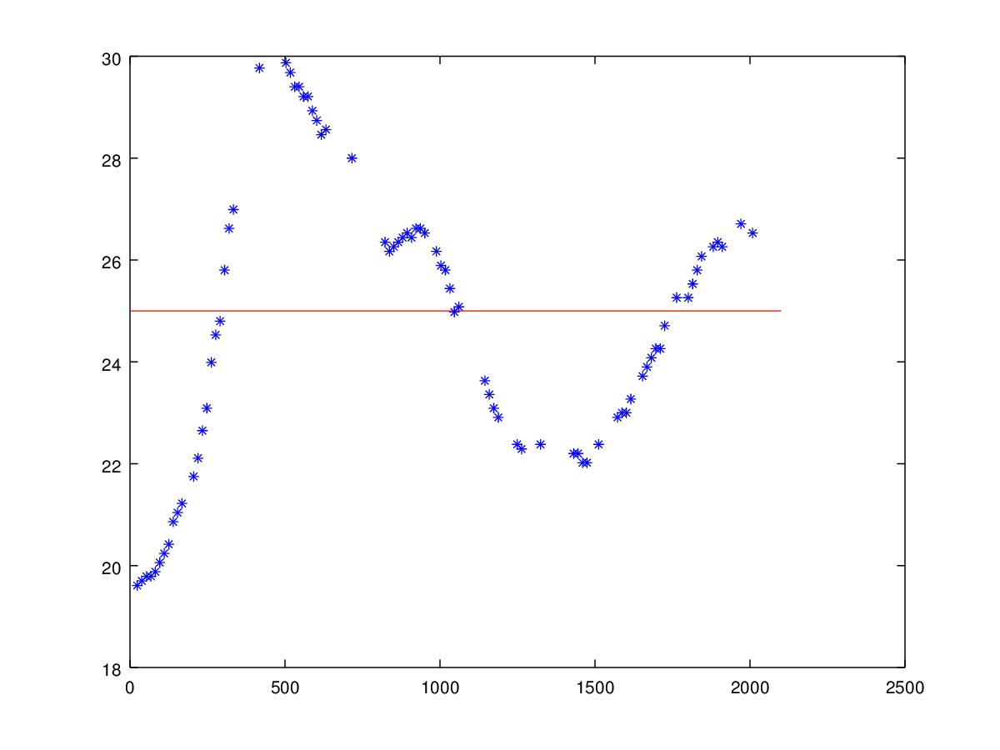
Rapports/Rapport des autres groupes/projet-thermostat/pid14.jpg
