defining/SmartThermostat/Rapports/Rapport final/thermostat-connecte/photos_membres/Soufiane.jpg

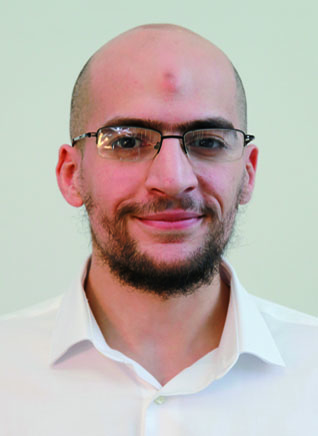
Rapports/Rapport final/thermostat-connecte/photos_membres/Soufiane.jpg
