defining/SmartThermostat/Rapports/Recherche bibliographique/Modèle tableau bibliographique/recherche biblio smart.numbers/preview-web.jpg

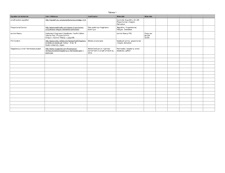
Rapports/Recherche bibliographique/Modèle tableau bibliographique/recherche biblio smart.numbers/preview-web.jpg
