defining/SmartThermostat/Rapports/Recherche bibliographique/recherche biblio smart.numbers/preview-web.jpg

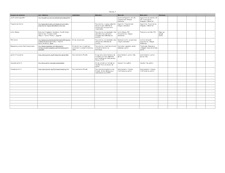
Rapports/Recherche bibliographique/recherche biblio smart.numbers/preview-web.jpg
