defining/SmartThermostat/Codes en vrac/Printscreen raspi Eppe/Capture d’écran 2016-03-10 à 00.14.22.png

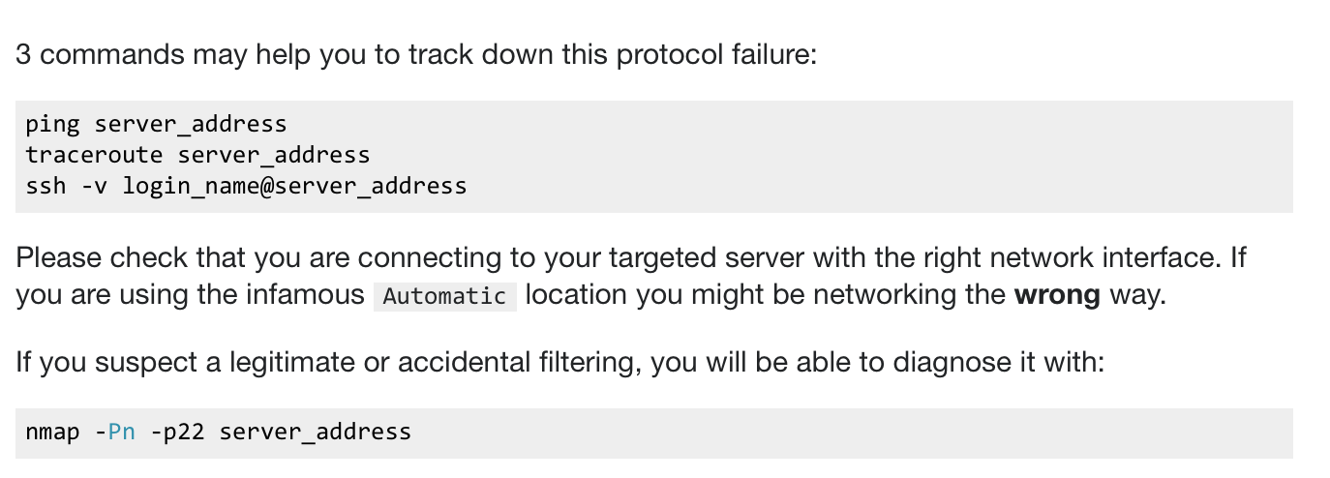
Codes en vrac/Printscreen raspi Eppe/Capture d’écran 2016-03-10 à 00.14.22.png
