defining/SmartThermostat/Codes en vrac/Printscreen raspi Eppe/Capture d’écran 2016-03-11 à 11.22.58.png

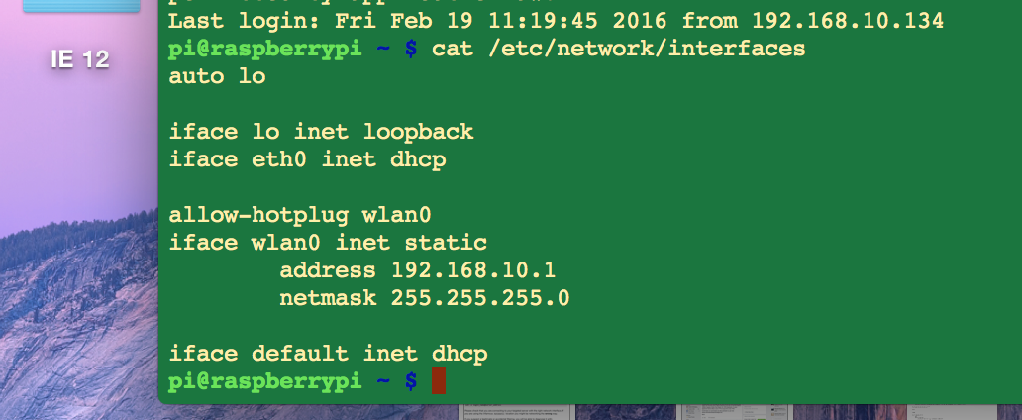
Codes en vrac/Printscreen raspi Eppe/Capture d’écran 2016-03-11 à 11.22.58.png
