defining/SmartThermostat/(list of files, drawings)

Other design files:
Diagrammes/Schema_Arduino/Schema_Arduino.fzz
